adafruit/Adafruit-Metro-M7-with-AirLift-PCB/Adafruit Metro M7 iMX RT1011 with AirLift.sch

## EAGLE design Adafruit Metro M7 iMX RT1011 with AirLift.sch (2023-03-08)

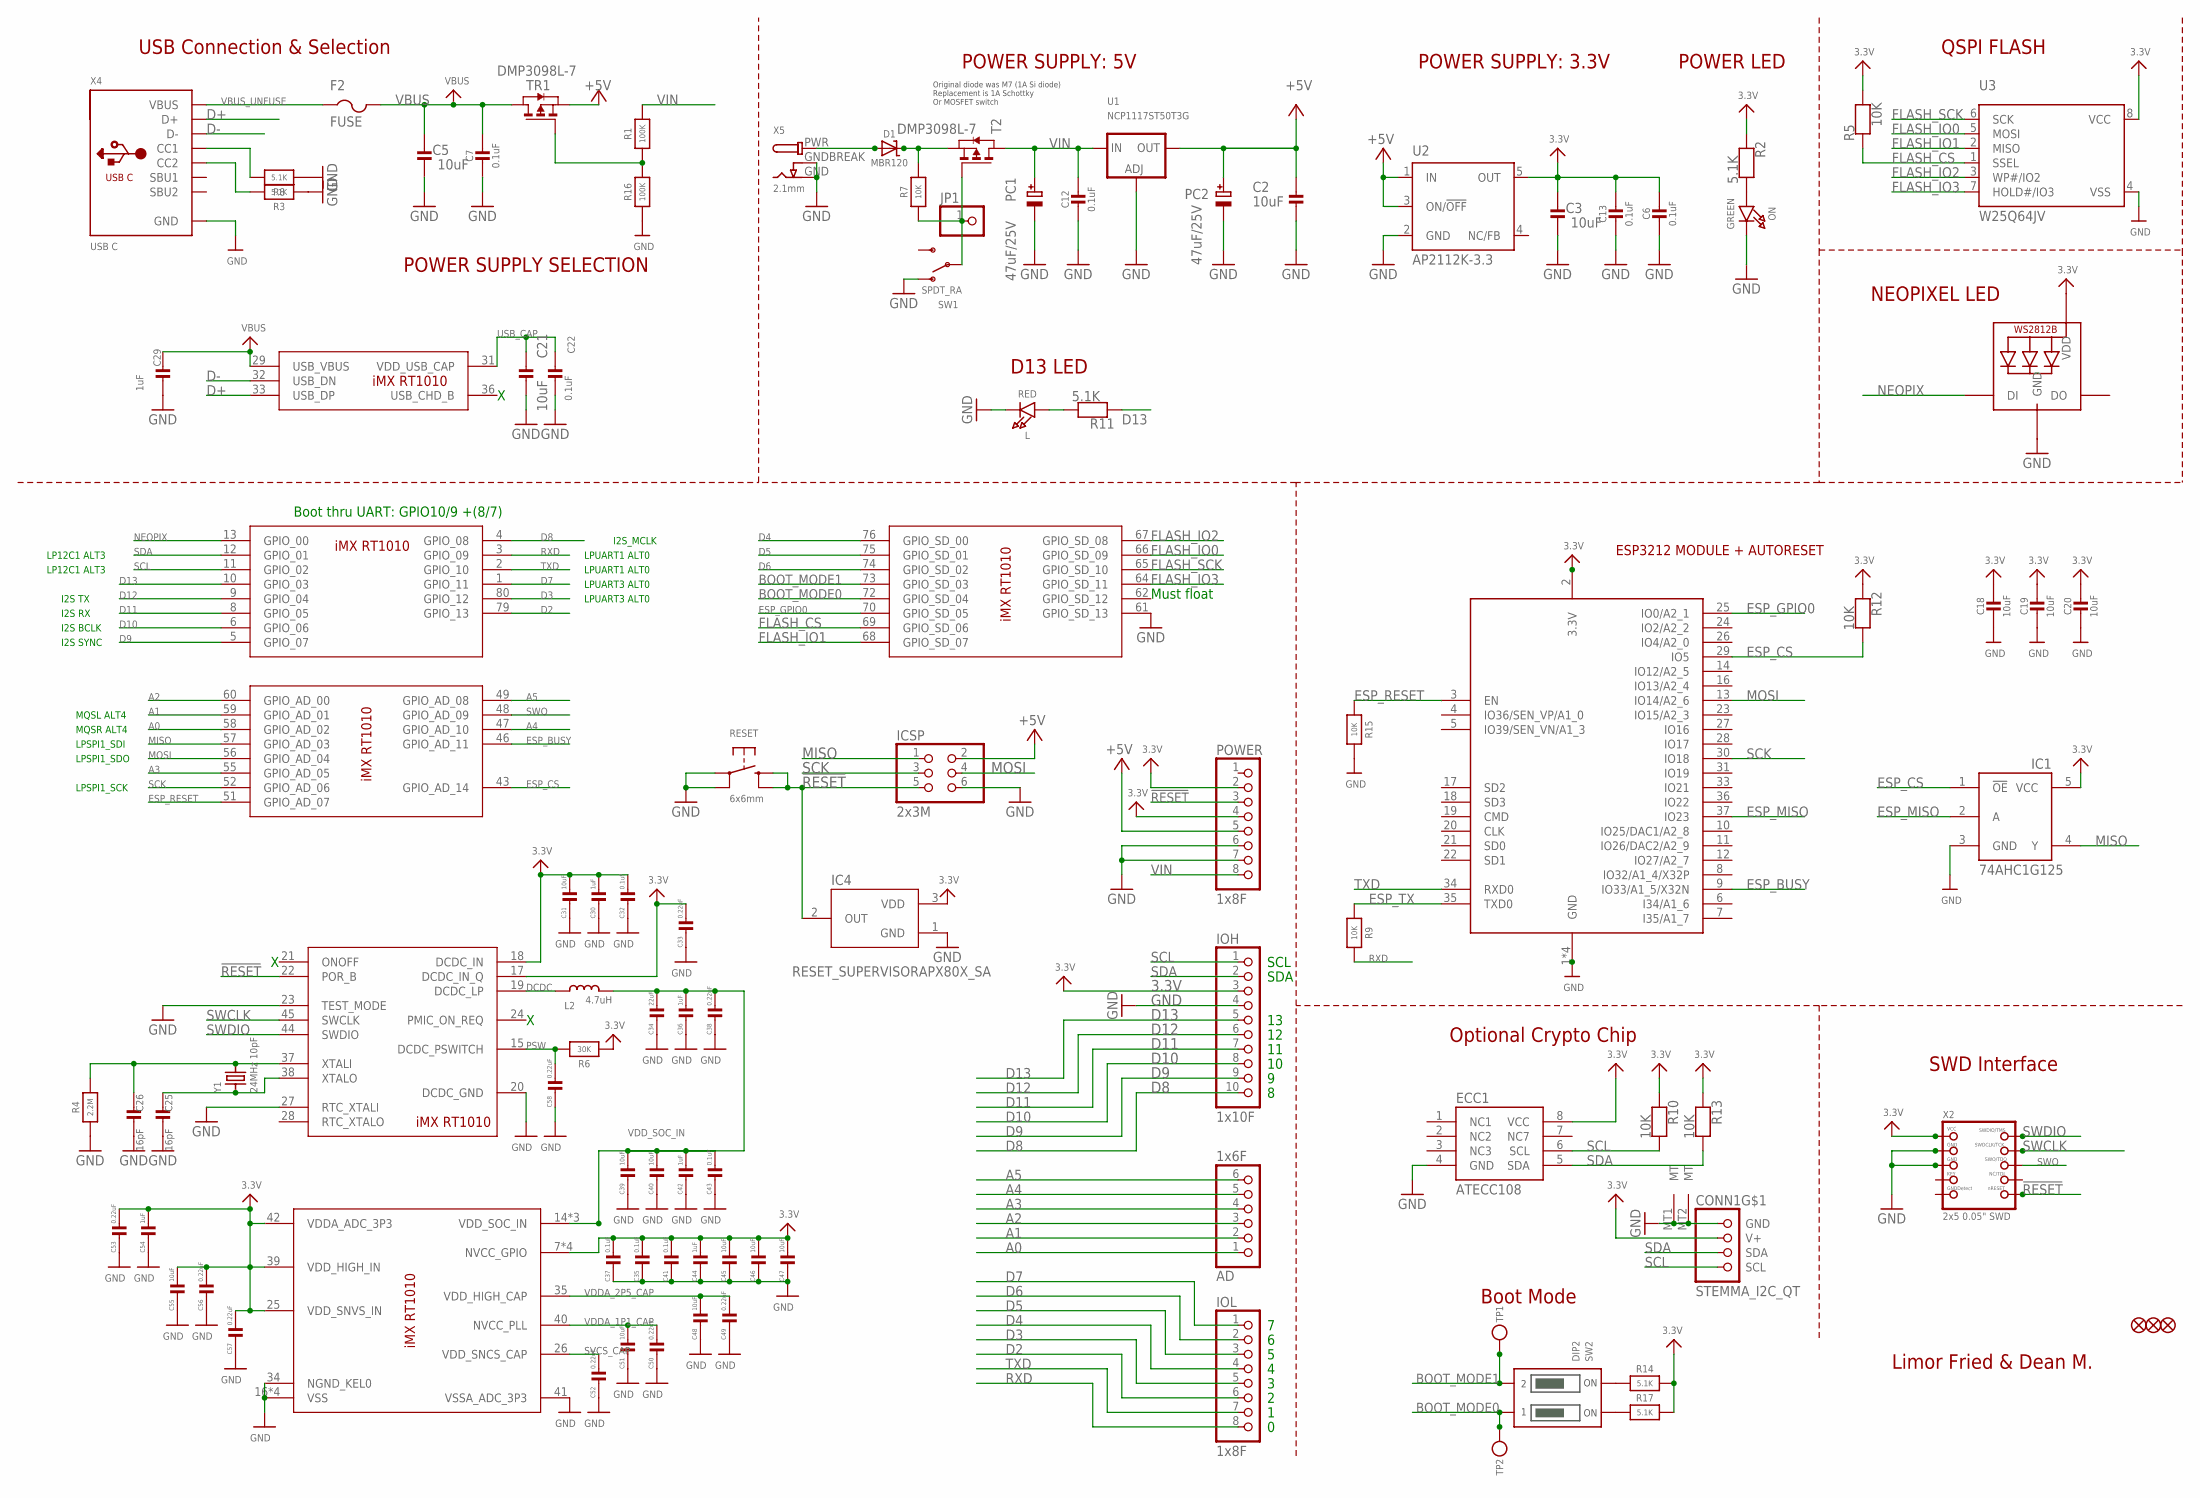
[picture p2: schematic Adafruit Metro M7 iMX RT1011 with AirLift.sch]

Parts:
AD: 1x6F; 1X06_OVALWAVE
C2, C3, C5, C18, C19, C20, C21, C31, C39, C40, C45, C46, C47, C48, C51, C55: 10uF; 0805-NO
C6, C7, C12, C13, C22, C32, C35, C37, C41, C43: 0.1uF; 0603-NO
C25, C26: 16pF; 0603-NO
C29, C30, C36, C42, C44, C54: 1uF; 0603-NO
C33, C38, C49, C50, C52, C53, C56, C57, C58: 0.22uF; 0603-NO
C34: 22uF; 0805-NO
CONN1: STEMMA_I2C_QT; JST_SH4
D1: MBR120; SOD-123
ECC1: ATECC108; SOIC8
F2: FUSE; R1206
FD1, FD2, FD3: FIDUCIAL_1MM
IC1: 74AHC1G125; SOT23-5L
IC2: IMX_RT1010; QFP50P1400X1400X160-80N
IC4: RESET_SUPERVISORAPX80X_SA; SOT23-WIDE
ICSP: 2x3M; 2X03_ROUND_70MIL
IOH: 1x10F; 1X10_OVALWAVE
IOL: 1x8F; 1X08_OVALWAVE
JP1: HEADER-1X1ROUND; 1X01_ROUND
L: RED; CHIPLED_0603_NOOUTLINE
L2: 4.7uH; INDUCTOR_1007
LED1: WS2812B_3535FULL; LED3535_FULLPADS
ON: GREEN; CHIPLED_0603_NOOUTLINE
PC1, PC2: 47uF/25V; PANASONIC_D
POWER: 1x8F; 1X08_OVALWAVE
R1, R16: 100K; 0603-NO
R2, R3, R8, R11, R14, R17: 5.1K; 0603-NO
R4: 2.2M; 0603-NO
R5, R7, R9, R10, R12, R13, R15: 10K; 0603-NO
R6: 30K; 0603-NO
RESET: 6x6mm; EVQ-Q2_SMALLER
SW1: SPDT_RA; SPDT_SMT_SSSS811101
SW2: DIP2; DIPSWITCH_2PIN
T2: DMP3098L-7; SOT-23
TP1, TP2: TESTPOINTROUND1.5MM; TESTPOINT_ROUND_1.5MM
TR1: DMP3098L-7; SOT-23
U1: NCP1117ST50T3G; SOT223-R
U2: AP2112K-3.3; SOT23-DBV
U3: W25Q64JV; SOIC8_208MIL
X2: 2x5 0.05" SWD; 2X05_1.27MM_BOX_POSTS
X4: USB C; USB_C_CUSB31-CFM2AX-01-X
X5: 2.1mm; DCJACK_2MM_PTH
X6: ESP32_WROOM32; WROOM32
Y1: 24MHz 10pF; CRYSTAL_2.5X2

Connections:
3.3V: C3.2, C6.2, C13.1, C18.1, C19.1, C20.1, C30.1, C31.1, C32.1, C33.1, C35.1, C37.1, C41.1, C44.1, C45.1, C46.1, C47.1, C53.1, C54.1, C55.1, C56.1, C57.1, CONN1.2 (V+), ECC1.8 (VCC), IC1.5 (VCC), IC2.7 (NVCC_GPIO), IC2.17 (DCDC_IN_Q), IC2.18 (DCDC_IN), IC2.25 (VDD_SNVS_IN), IC2.39 (VDD_HIGH_IN), IC2.42 (VDDA_ADC_3P3), IC4.3 (VDD), IOH.3, LED1.2 (VDD), POWER.2, POWER.4, R2.1, R5.2, R6.1, R10.1, R12.1, R13.1, R14.2, R17.2, U2.5 (OUT), U3.8 (VCC), X2.1 (VCC), X6.2 (3.3V)
!RESET: IC2.22 (POR_B), IC4.2 (OUT), ICSP.5, POWER.3, RESET.B (S), RESET.B' (S1), X2.10 (NRESET)
+5V: C2.2, ICSP.2, PC2.+, POWER.5, TR1.2 (S), U1.2 (OUT), U2.1 (IN), U2.3 (ON/!OFF)
A0: AD.1, IC2.58 (GPIO_AD_02)
A1: AD.2, IC2.59 (GPIO_AD_01)
A2: AD.3, IC2.60 (GPIO_AD_00)
A3: AD.4, IC2.55 (GPIO_AD_05)
A4: AD.5, IC2.47 (GPIO_AD_10)
A5: AD.6, IC2.49 (GPIO_AD_08)
BOOT_MODE0: IC2.72 (GPIO_SD_04), SW2.1OFF, TP2.P$1
BOOT_MODE1: IC2.73 (GPIO_SD_03), SW2.2OFF, TP1.P$1
D2: IC2.79 (GPIO_13), IOL.6
D3: IC2.80 (GPIO_12), IOL.5
D4: IC2.76 (GPIO_SD_00), IOL.4
D5: IC2.75 (GPIO_SD_01), IOL.3
D6: IC2.74 (GPIO_SD_02), IOL.2
D7: IC2.1 (GPIO_11), IOL.1
D8: IC2.4 (GPIO_08), IOH.10
D9: IC2.5 (GPIO_07), IOH.9
D10: IC2.6 (GPIO_06), IOH.8
D11: IC2.8 (GPIO_05), IOH.7
D12: IC2.9 (GPIO_04), IOH.6
D13: IC2.10 (GPIO_03), IOH.5, R11.1
D+: IC2.33 (USB_DP), X4.A6 (D+)
D-: IC2.32 (USB_DN), X4.A7 (D-)
DCDC: IC2.19 (DCDC_LP), L2.P$1 (1)
ESP_BUSY: IC2.46 (GPIO_AD_11), X6.9 (IO33/A1_5/X32N)
ESP_CS: IC1.1 (!OE), IC2.43 (GPIO_AD_14), R12.2, X6.29 (IO5)
ESP_GPIO0: IC2.70 (GPIO_SD_05), X6.25 (IO0/A2_1)
ESP_MISO: IC1.2 (A), X6.37 (IO23)
ESP_RESET: IC2.51 (GPIO_AD_07), R15.1, X6.3 (EN)
ESP_TX: R9.1, X6.35 (TXD0)
FLASH_CS: IC2.69 (GPIO_SD_06), R5.1, U3.1 (SSEL)
FLASH_IO0: IC2.66 (GPIO_SD_09), U3.5 (MOSI)
FLASH_IO1: IC2.68 (GPIO_SD_07), U3.2 (MISO)
FLASH_IO2: IC2.67 (GPIO_SD_08), U3.3 (WP#/IO2)
FLASH_IO3: IC2.64 (GPIO_SD_11), U3.7 (HOLD#/IO3)
FLASH_SCK: IC2.65 (GPIO_SD_10), U3.6 (SCK)
GND: C2.1, C3.1, C5.1, C6.1, C7.2, C12.2, C13.2, C18.2, C19.2, C20.2, C21.1, C22.2, C25.2, C26.2, C29.2, C30.2, C31.2, C32.2, C33.2, C34.2, C35.2, C36.2, C37.2, C38.2, C39.2, C40.2, C41.2, C42.2, C43.2, C44.2, C45.2, C46.2, C47.2, C48.2, C49.2, C50.2, C51.2, C52.2, C53.2, C54.2, C55.2, C56.2, C57.2, C58.2, CONN1.1 (GND), CONN1.MT1 (MT), CONN1.MT2 (MT), ECC1.4 (GND), IC1.3 (GND), IC2.16 (VSS), IC2.20 (DCDC_GND), IC2.23 (TEST_MODE), IC2.27 (RTC_XTALI), IC2.34 (NGND_KEL0), IC2.41 (VSSA_ADC_3P3), IC2.61 (GPIO_SD_13), IC4.1 (GND), ICSP.6, IOH.4, L.C, LED1.4 (GND), ON.C, PC1.-, PC2.-, POWER.6, POWER.7, R3.1, R4.1, R8.1, R15.2, R16.1, RESET.A, RESET.A' (P1), SW1.A (O), U1.1 (ADJ), U2.2 (GND), U3.4 (VSS), X2.3 (GND), X2.5 (GND), X4.A1B12 (GND), X5.GND, X5.GNDBREAK, X6.1 (GND)
MISO: IC1.4 (Y), IC2.57 (GPIO_AD_03), ICSP.1
MOSI: IC2.56 (GPIO_AD_04), ICSP.4, X6.13 (IO14/A2_6)
unnamed: L.A, R11.2
unnamed: ON.A, R2.2
unnamed: R14.1, SW2.2ON
unnamed: R17.1, SW2.1ON
unnamed: R8.2, X4.A5 (CC1)
unnamed: R3.2, X4.B5 (CC2)
unnamed: C26.1, IC2.37 (XTALI), R4.2, Y1.3 (2)
unnamed: C25.1, IC2.38 (XTALO), Y1.1
unnamed: R1.1, R16.2, TR1.3 (G)
unnamed: D1.C, R7.2, T2.2 (S)
NEOPIX: IC2.13 (GPIO_00), LED1.1 (DI)
PSW: C58.1, IC2.15 (DCDC_PSWITCH), R6.2
PWRIN: D1.A, X5.PWR
PWR_SWITCH: JP1.1, R7.1, SW1.B, T2.3 (G)
RXD: IC2.3 (GPIO_09), IOL.8, R9.2
SCK: IC2.52 (GPIO_AD_06), ICSP.3, X6.30 (IO18)
SCL: CONN1.4 (SCL), ECC1.6 (SCL), IC2.11 (GPIO_02), IOH.1, R10.2
SDA: CONN1.3 (SDA), ECC1.5 (SDA), IC2.12 (GPIO_01), IOH.2, R13.2
SVCS_CAP: C52.1, IC2.26 (VDD_SNCS_CAP)
SWCLK: IC2.45 (SWCLK), X2.4 (SWDCLK)
SWDIO: IC2.44 (SWDIO), X2.2 (SWDIO)
SWO: IC2.48 (GPIO_AD_09), X2.6 (SWO)
TXD: IC2.2 (GPIO_10), IOL.7, X6.34 (RXD0)
USB_CAP: C21.2, C22.1, IC2.31 (VDD_USB_CAP)
VBUS: C5.2, C7.1, C29.1, F2.2, IC2.29 (USB_VBUS), TR1.1 (D)
VBUS_UNFUSE: F2.1, X4.A4B9 (VBUS)
VDDA_1P1_CAP: C50.1, C51.1, IC2.40 (NVCC_PLL)
VDDA_2P5_CAP: C48.1, C49.1, IC2.35 (VDD_HIGH_CAP)
VDD_SOC_IN: C34.1, C36.1, C38.1, C39.1, C40.1, C42.1, C43.1, IC2.14 (VDD_SOC_IN), L2.P$2 (2)
VIN: C12.1, PC1.+, POWER.8, R1.2, T2.1 (D), U1.3 (IN)

Notes on the sheet:
SDA
SCL
Limor Fried & Dean M.
Original diode was M7 (1A Si diode) Replacement is 1A Schottky Or MOSFET switch
POWER SUPPLY: 5V
USB Connection & Selection
POWER SUPPLY: 3.3V
POWER LED
POWER SUPPLY SELECTION
D13 LED
NEOPIXEL LED
QSPI FLASH
SWD Interface
ESP3212 MODULE + AUTORESET
Optional Crypto Chip
Boot Mode
Must float
Boot thru UART: GPIO10/9 +(8/7)
LPSPI1_SCK
LPSPI1_SDI
LPSPI1_SDO
LP12C1 ALT3
LPUART1 ALT0
MQSL ALT4
MQSR ALT4
I2S BCLK
I2S SYNC
I2S RX
I2S TX
I2S_MCLK
LPUART3 ALT0
